pkladiev/CubeSat3U-model/(commit log)

2025-04-12 Добавлены описание и фотографии
2025-04-13 Добавлена схема подключения
